davidpalma666/device.timestampgeneratorgen3-FORK/(commit log)

2026-05-26 1º commit antes de revisão com Filipe
    [IOs stage.kicad_sch, LEDs & IDC.kicad_sch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]
2026-05-28 corrigidos MPN & OEPSPN
    [core.kicad_sch, harp timestamp generator Gen3.kicad_pcb, harp timestamp generator Gen3.kicad_sch]
2026-05-28 actualizada PCB com OEPSPN & MPN
    [harp timestamp generator Gen3.kicad_pcb, harp timestamp generator Gen3.kicad_sch]
2026-06-02 commit para revisão do Filipe
    [IOs stage.kicad_sch, Power Management.kicad_sch, core.kicad_sch, harp timestamp generator Gen3.kicad_pcb, harp timestamp generator Gen3.kicad_sch]
2026-06-03 1ª review depois de comentários do Filipe
    [IOs stage.kicad_sch, LEDs & IDC.kicad_sch, Power Management.kicad_sch, core.kicad_sch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]
2026-06-18 corrigida dimensão em rear panel da ficha USB-C
    [harp timestamp generator Gen3 rear panel.kicad_pcb]
2026-06-19 ajuste posição ficha USB-C
    > ajuste posição ficha USB-C
    . actualizados manufacturing files:
    Gerbers & Drills & .d356 & P&P
    [Power Management.kicad_sch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]
2026-06-19 corrigidas opções sobre DRL files
    [harp timestamp generator Gen3-B_Cu.gbr, harp timestamp generator Gen3-B_Fab.gbr, harp timestamp generator Gen3-B_Mask.gbr, harp timestamp generator Gen3-B_Paste.gbr, harp timestamp generator Gen3-B_Silkscreen.gbr, harp timestamp generator Gen3-Edge_Cuts.gbr, harp timestamp generator Gen3-F_Cu.gbr, harp timestamp generator Gen3-F_Fab.gbr]
2026-07-29 review após 1ª produção de placas teste
    > harp timestamp generator Gen3
    . mudança da case de Q2
    . mudança de ligação em 'Button0'
    > harp timestamp generator Gen3 front panel
    . acerto no recorte da ficha IDC e interruptor bateria
    . modificação de setup no logo 'harp'
    > harp timestamp generator Gen3 rear panel
    . acerto no recorte de ficha USB
    [Power Management.kicad_sch, core.kicad_sch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]
2026-07-29 harp timestamp generator Gen3 - em falta update de P&P files
    >> harp timestamp generator Gen3
    . actualização de ficheiros Pick-&-Place
    N.B. - BOM não modificada
2026-07-31 ajuste recorte ficha USB-C no rear panel
    - Gerbers & Drills actualizados no projecto rear-panel
    [harp timestamp generator Gen3 rear panel-B_Cu.gbr, harp timestamp generator Gen3 rear panel-B_Mask.gbr, harp timestamp generator Gen3 rear panel-B_Paste.gbr, harp timestamp generator Gen3 rear panel-B_Silkscreen.gbr, harp timestamp generator Gen3 rear panel-Edge_Cuts.gbr, harp timestamp generator Gen3 rear panel-F_Cu.gbr, harp timestamp generator Gen3 rear panel-F_Mask.gbr, harp timestamp generat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]
2026-08-12 em passo de desenvolvimento Power-Select & Battery Protection
    [Power Management.kicad_sch]
